JustARandomBoredGuy/Res-Novae/Media/nozzle and closure irl 1.jpg

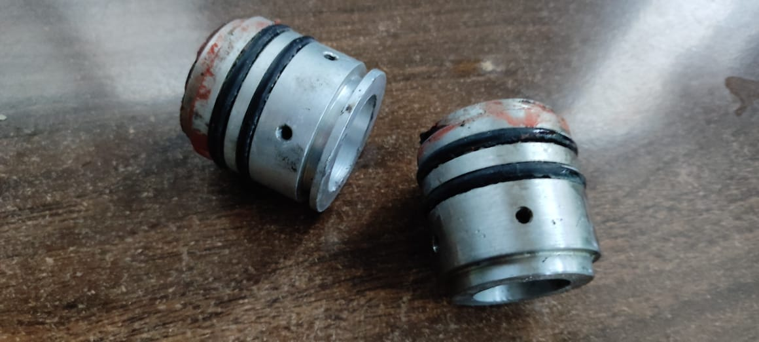
Media/nozzle and closure irl 1.jpg
