JustARandomBoredGuy/Res-Novae/Media/green thingy 50x.jpg

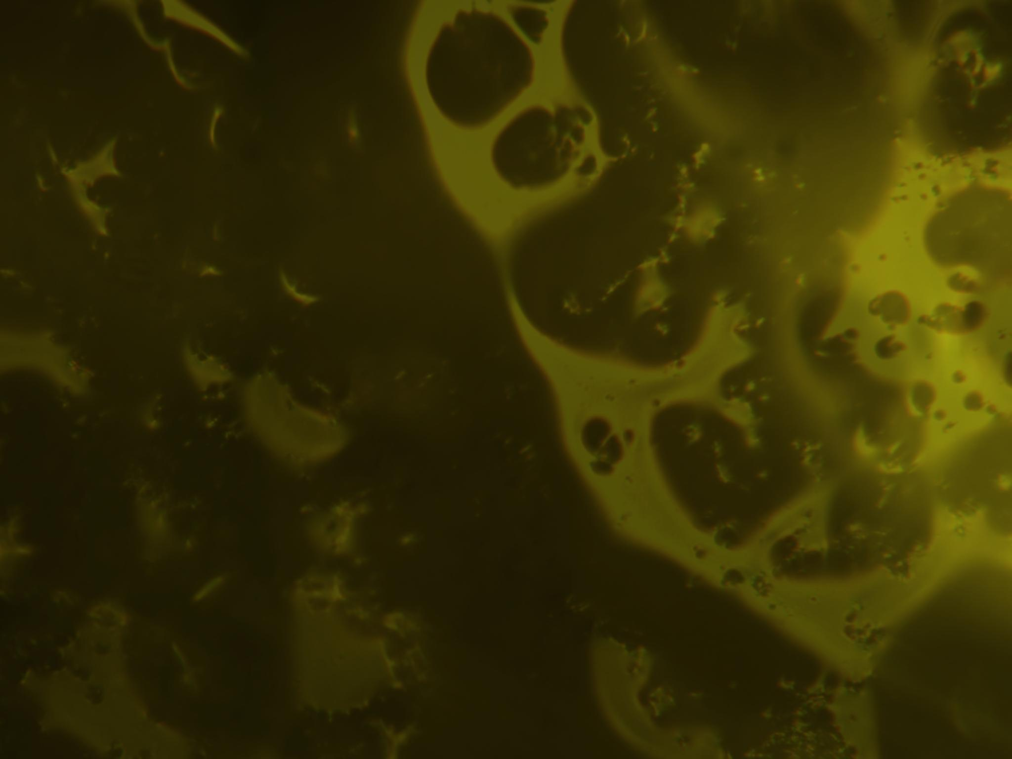
Media/green thingy 50x.jpg
