JustARandomBoredGuy/Res-Novae/README.md

# Res-Novae: Solid Propellant Telemetry System
Field Analysis to obtain thrust curves and impulse of varying propellant Compositions

## Tech Stack & Tools
Arduino IDE for embedded programming

LittleFS for storing web content on flash memory

AsyncWebServer for hosting a live dashboard

HTML + CSS + JavaScript for the front-end telemetry UI

## Visuals
Load Cell Setup:



NodeMCU and Dashboard:
