JustARandomBoredGuy/Res-Novae/Media/Aluminium 1.jpg

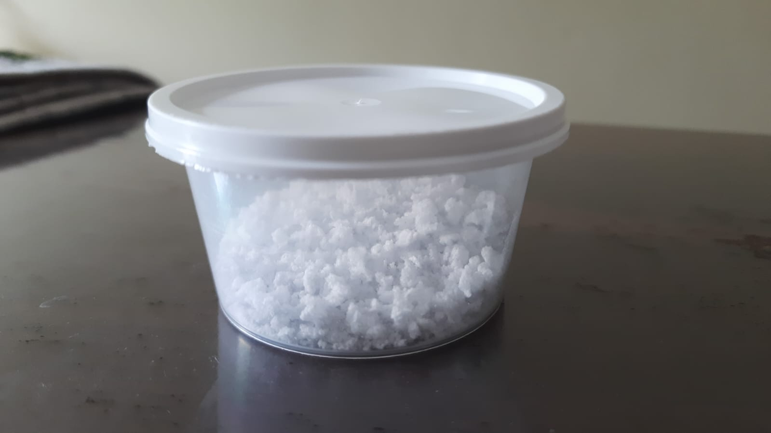
Media/Aluminium 1.jpg
