JustARandomBoredGuy/Res-Novae/Media/Caramalised KNDX 1.jpg

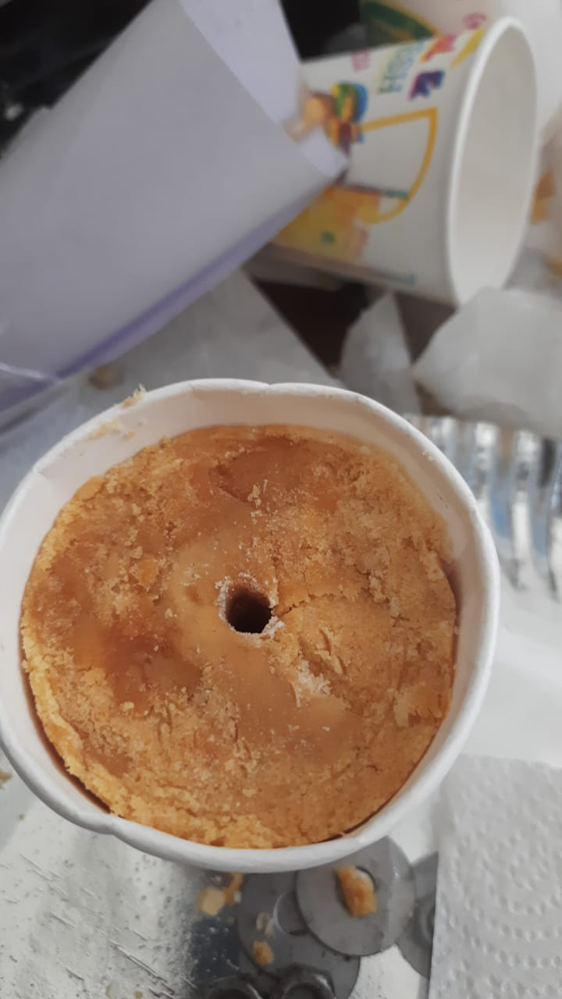
Media/Caramalised KNDX 1.jpg
