JustARandomBoredGuy/Res-Novae/Media/casing irl 1.jpg

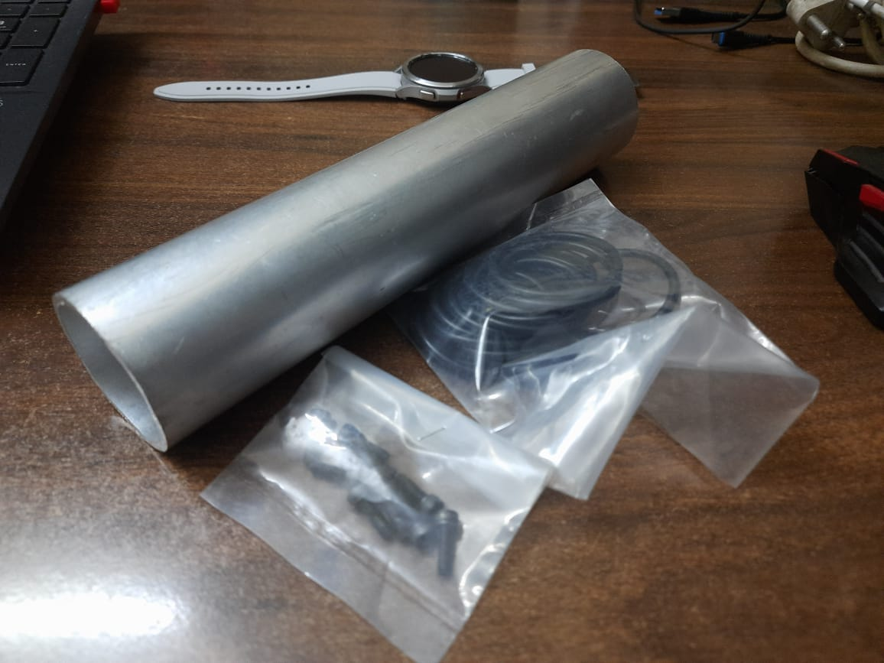
Media/casing irl 1.jpg
