JustARandomBoredGuy/Res-Novae/Media/casing irl 2.jpg

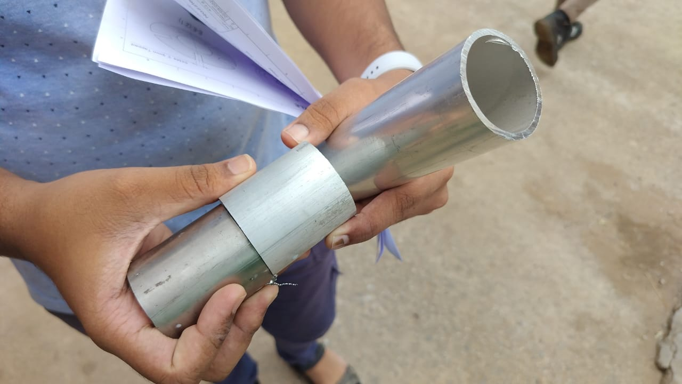
Media/casing irl 2.jpg
