JustARandomBoredGuy/Res-Novae/Media/FUEL.jpg

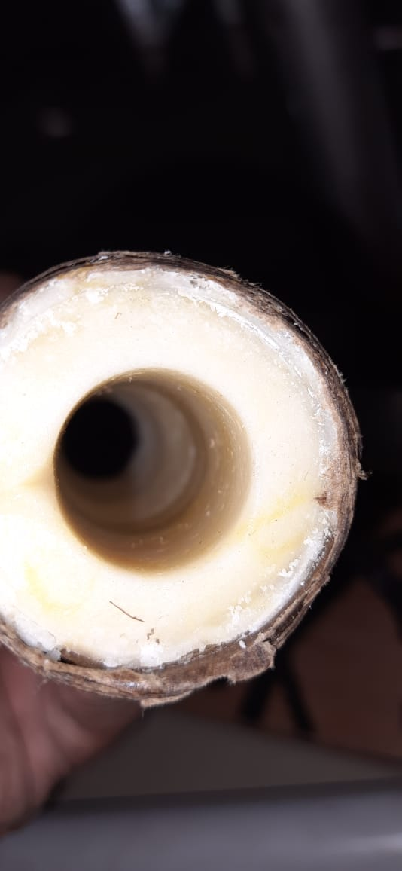
Media/FUEL.jpg
