JustARandomBoredGuy/Res-Novae/Media/green thingy 1.jpg

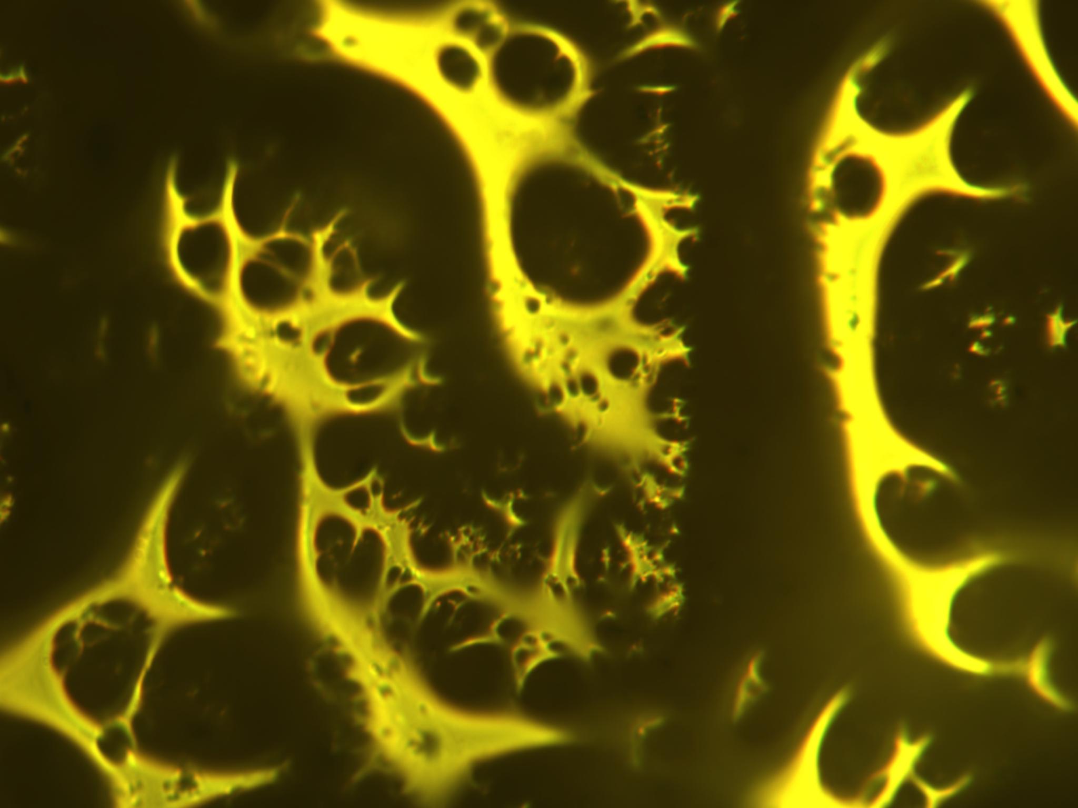
Media/green thingy 1.jpg
