JustARandomBoredGuy/Res-Novae/Media/liner 1.jpg

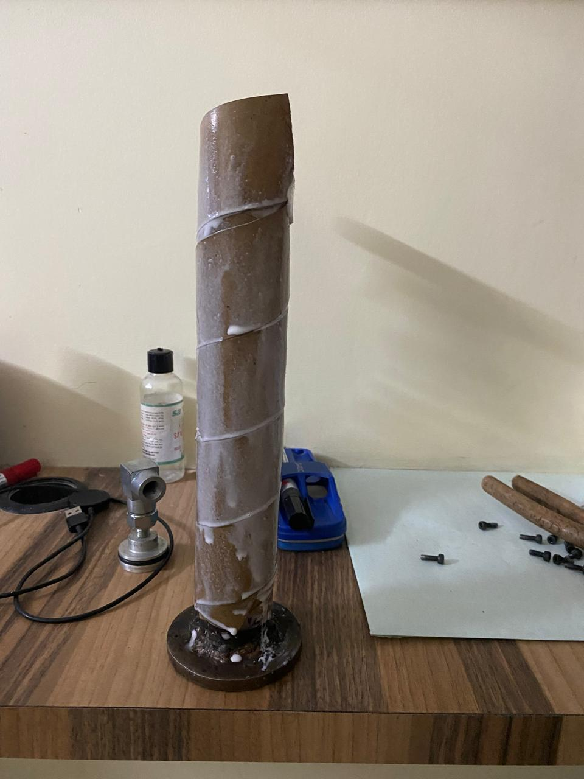
Media/liner 1.jpg
