JustARandomBoredGuy/Res-Novae/Media/liner 2.jpg

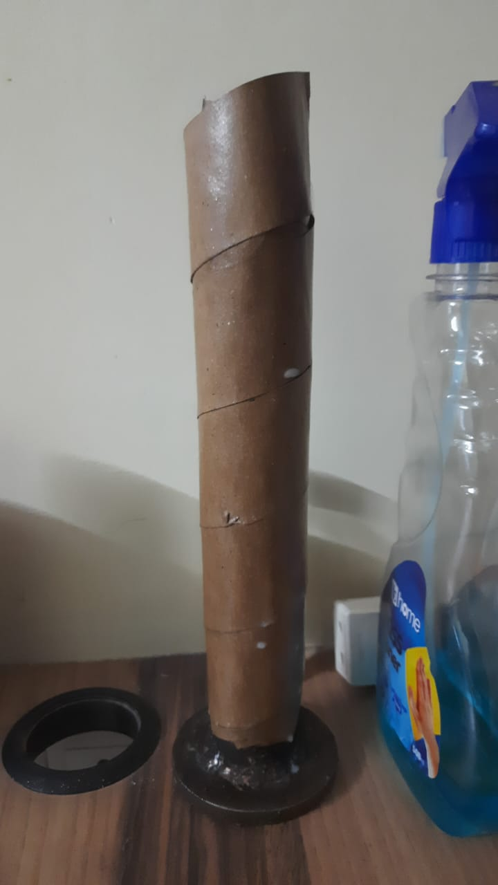
Media/liner 2.jpg
