JustARandomBoredGuy/Res-Novae/Media/model irl 1.jpg

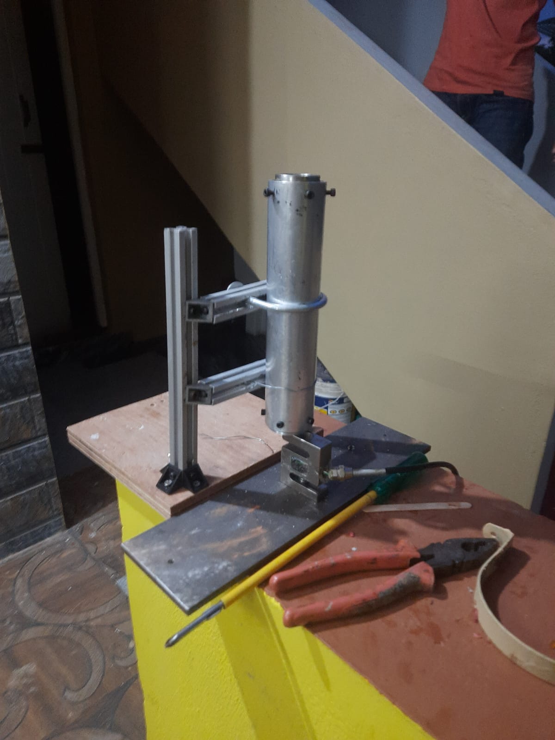
Media/model irl 1.jpg
