JustARandomBoredGuy/Res-Novae/Media/orange thingy 20x.jpg

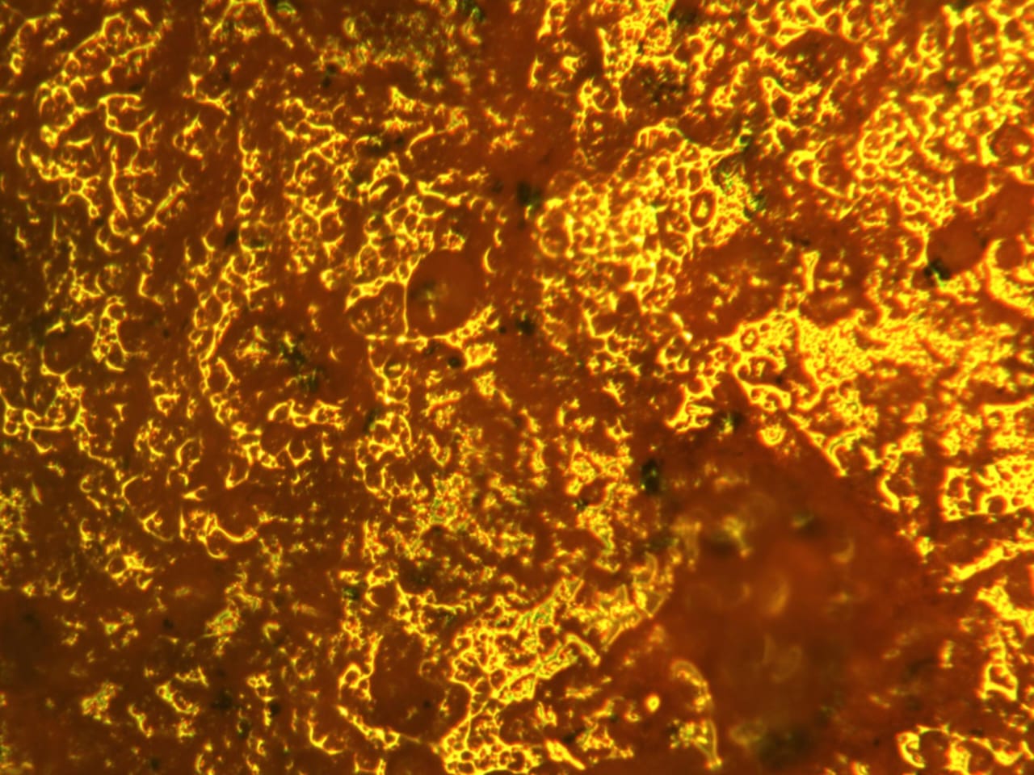
Media/orange thingy 20x.jpg
