JustARandomBoredGuy/Res-Novae/Media/orange thingy 50x.jpg

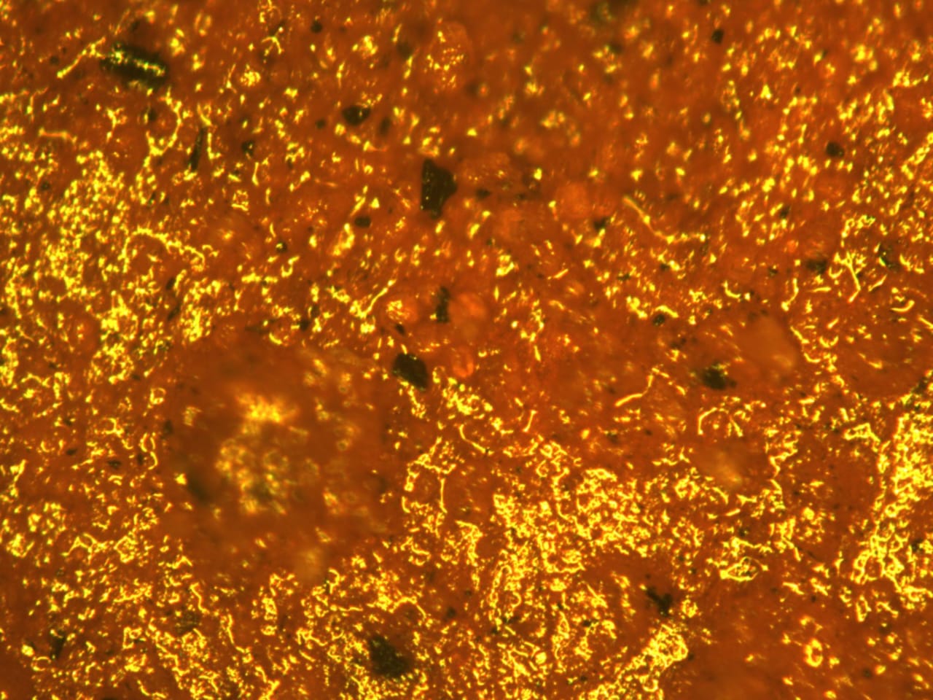
Media/orange thingy 50x.jpg
