JustARandomBoredGuy/Res-Novae/Media/pressure contour 1.jpg

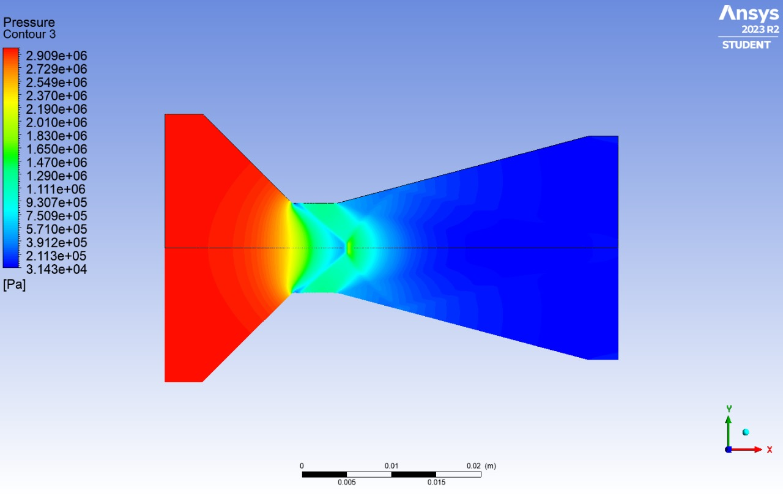
Media/pressure contour 1.jpg
