JustARandomBoredGuy/Res-Novae/Media/velocity contour 1.jpg

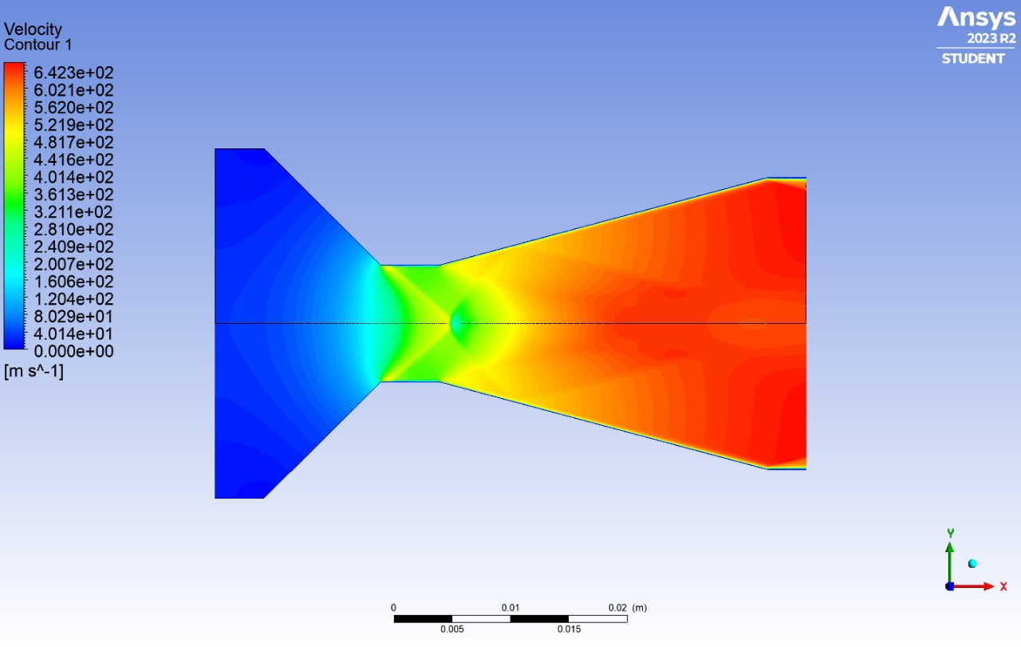
Media/velocity contour 1.jpg
