JustARandomBoredGuy/Res-Novae/Results/Thrust Curves.xlsx

Grams | Time (s) | Force (N) | Area | Ideal thrust
13.26 | 0.394 | 0.129948 | 0.08494395 | 0
13.41 | 1.044 | 0.131418 | 0.08710975 | 0
13.94 | 1.694 | 0.136612 | 0.0900081 | 0 | Burntime | 2.881
14.32 | 2.344 | 0.140336 | 0.09169615 | 0
14.47 | 2.994 | 0.141806 | 0.09411675 | 0
15.08 | 3.644 | 0.147784 | 0.10641085 | 0
18.33 | 4.294 | 0.179634 | 0.03276189 | 0
52.05 | 4.389 | 0.51009 | 0.091944384 | 0
143.41 | 4.485 | 1.405418 | 0.198261105 | 0
282.5 | 4.58 | 2.7685 | 0.34217974 | 0
452.58 | 4.675 | 4.435284 | 0.51459163 | 0
652.88 | 4.77 | 6.398224 | 3.703589347 | 0
7139.228873 | 4.867 | 69.96444296 | 7.343201023 | 122.2456
8635.63906 | 4.962 | 84.62926279 | 8.702555327 | 132.22437
10059.43146 | 5.057 | 98.58242831 | 9.890041512 | 142.19267 |  | 95.82117251
11186.62979 | 5.152 | 109.6289719 | 10.86683946 | 155.46847
11914.64457 | 5.248 | 116.7635168 | 11.36520391 | 165.41455
12246.07803 | 5.344 | 120.0115647 | 11.42948682 | 175.35192
12307.06229 | 5.439 | 120.6092104 | 11.45787499 | 188.58892
12307.06229 | 5.534 | 120.6092104 | 11.41220026 | 198.50753
12208.94256 | 5.629 | 119.6476371 | 11.35624644 | 208.41869
11932.7378 | 5.725 | 116.9408304 | 11.02785816 | 221.62249
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
