JustARandomBoredGuy/Res-Novae/Presentation/Res Novae Poster.pdf

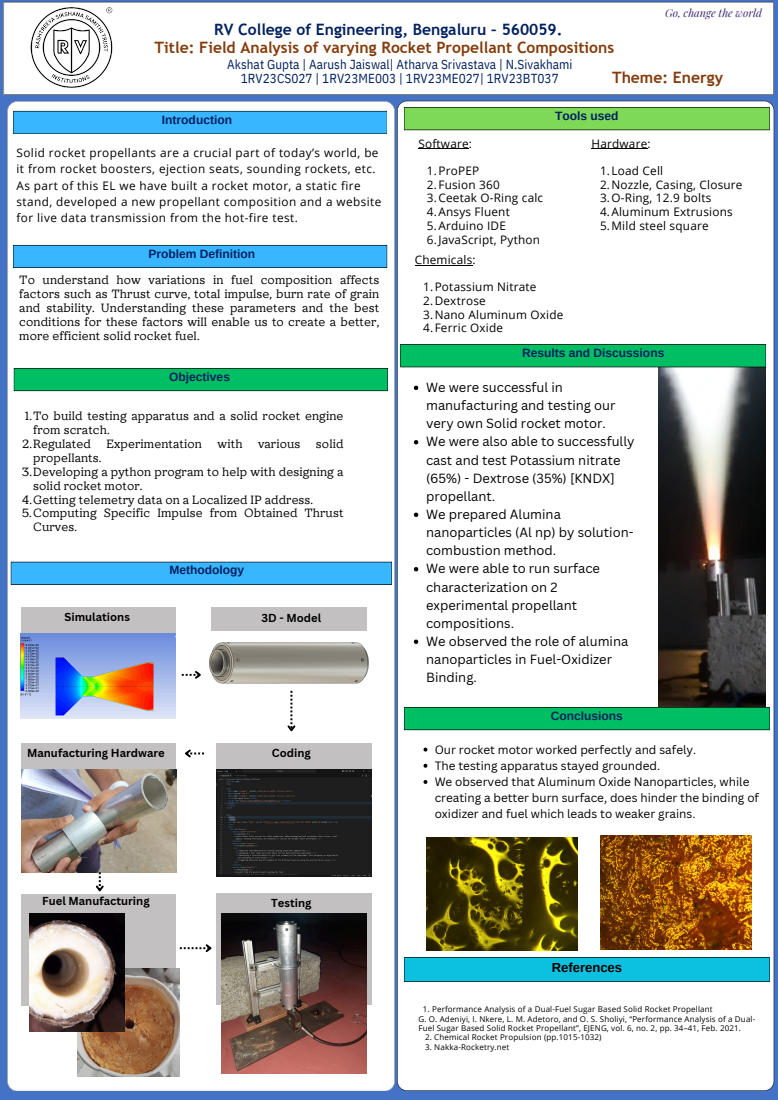
[picture p34: page 1]
Introduction; Methodology; References; Objectives; Problem Definition; Conclusions; Theme: Energy; Simulations; Manufacturing Hardware; Fuel Manufacturing; Testing; Coding; 3D - Model

Go, change the world

RV College of Engineering, Bengaluru – 560059.

Title: Field Analysis of varying Rocket Propellant Compositions

Akshat Gupta | Aarush Jaiswal| Atharva Srivastava | N.Sivakhami

Tools used
Hardware:
1.Load Cell
2.Nozzle, Casing, Closure
3.O-Ring, 12.9 bolts
4.Aluminum Extrusions
5.Mild steel square

Software:
1.ProPEP
2.Fusion 360
3.Ceetak O-Ring calc
4.Ansys Fluent
5.Arduino IDE
6.JavaScript, Python
Chemicals:
1.Potassium Nitrate
2.Dextrose
3.Nano Aluminum Oxide
4.Ferric Oxide

Solid rocket propellants are a crucial part of today’s world, be
it from rocket boosters, ejection seats, sounding rockets, etc.
As part of this EL we have built a rocket motor, a static fire
stand, developed a new propellant composition and a website
for live data transmission from the hot-fire test.

To understand how variations in fuel composition affects
factors such as Thrust curve, total impulse, burn rate of grain
and stability. Understanding these parameters and the best
conditions for these factors will enable us to create a better,
more efficient solid rocket fuel.

Results and Discussions

We were successful in
manufacturing and testing our
very own Solid rocket motor.
We were also able to successfully
cast and test Potassium nitrate
(65%) - Dextrose (35%) [KNDX]
propellant.
We prepared Alumina
nanoparticles (Al np) by solution-
combustion method.
We were able to run surface
characterization on 2
experimental propellant
compositions.
We observed the role of alumina
nanoparticles in Fuel-Oxidizer
Binding.

To build testing apparatus and a solid rocket engine
from scratch.
Regulated Experimentation with various solid
propellants.
Developing a python program to help with designing a
solid rocket motor.
4.Getting telemetry data on a Localized IP address.
Computing Specific Impulse from Obtained Thrust
Curves.

Our rocket motor worked perfectly and safely.
The testing apparatus stayed grounded.
We observed that Aluminum Oxide Nanoparticles, while
creating a better burn surface, does hinder the binding of
oxidizer and fuel which leads to weaker grains.

1. Performance Analysis of a Dual-Fuel Sugar Based Solid Rocket Propellant
G. O. Adeniyi, I. Nkere, L. M. Adetoro, and O. S. Sholiyi, “Performance Analysis of a Dual-
Fuel Sugar Based Solid Rocket Propellant”, EJENG, vol. 6, no. 2, pp. 34–41, Feb. 2021.
2. Chemical Rocket Propulsion (pp.1015-1032)
3. Nakka-Rocketry.net
