JustARandomBoredGuy/Res-Novae/CAD/H CLASS FINAL Drawing.pdf

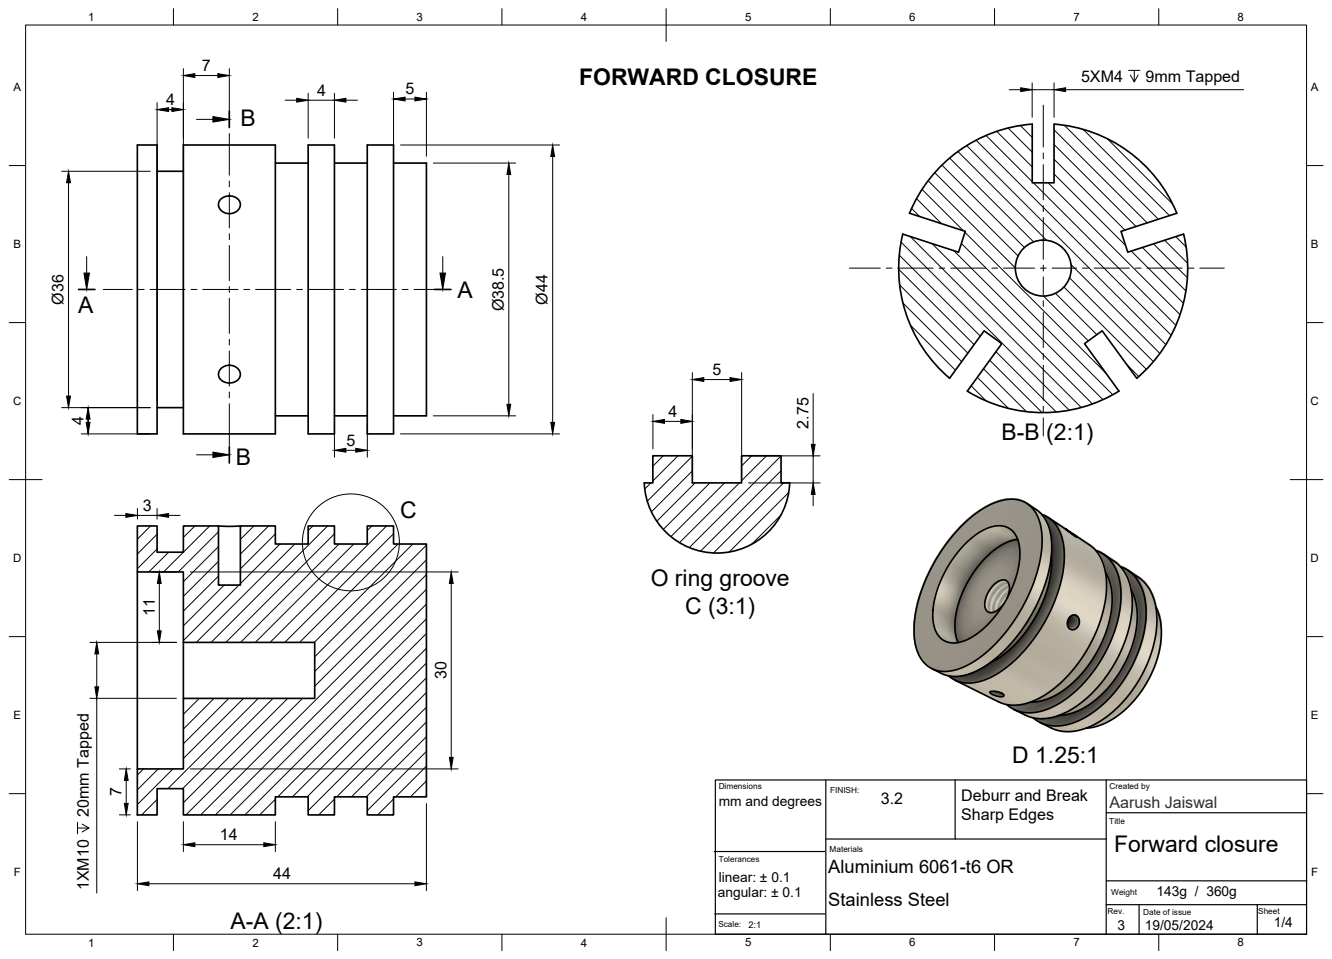
[picture p35: page 1]
Dimensions; FINISH:; Created by; Rev.; Date of issue; Sheet; Aluminium 6061-t6 OR; Forward closure; mm and degrees; Aarush Jaiswal; linear: ± 0.1; Stainless Steel; FORWARD CLOSURE; 9mm Tapped Ø38.5; 7 1XM10 20mm Tapped; angular: ± 0.1; O ring groove C (3:1)

Deburr and Break
Sharp Edges

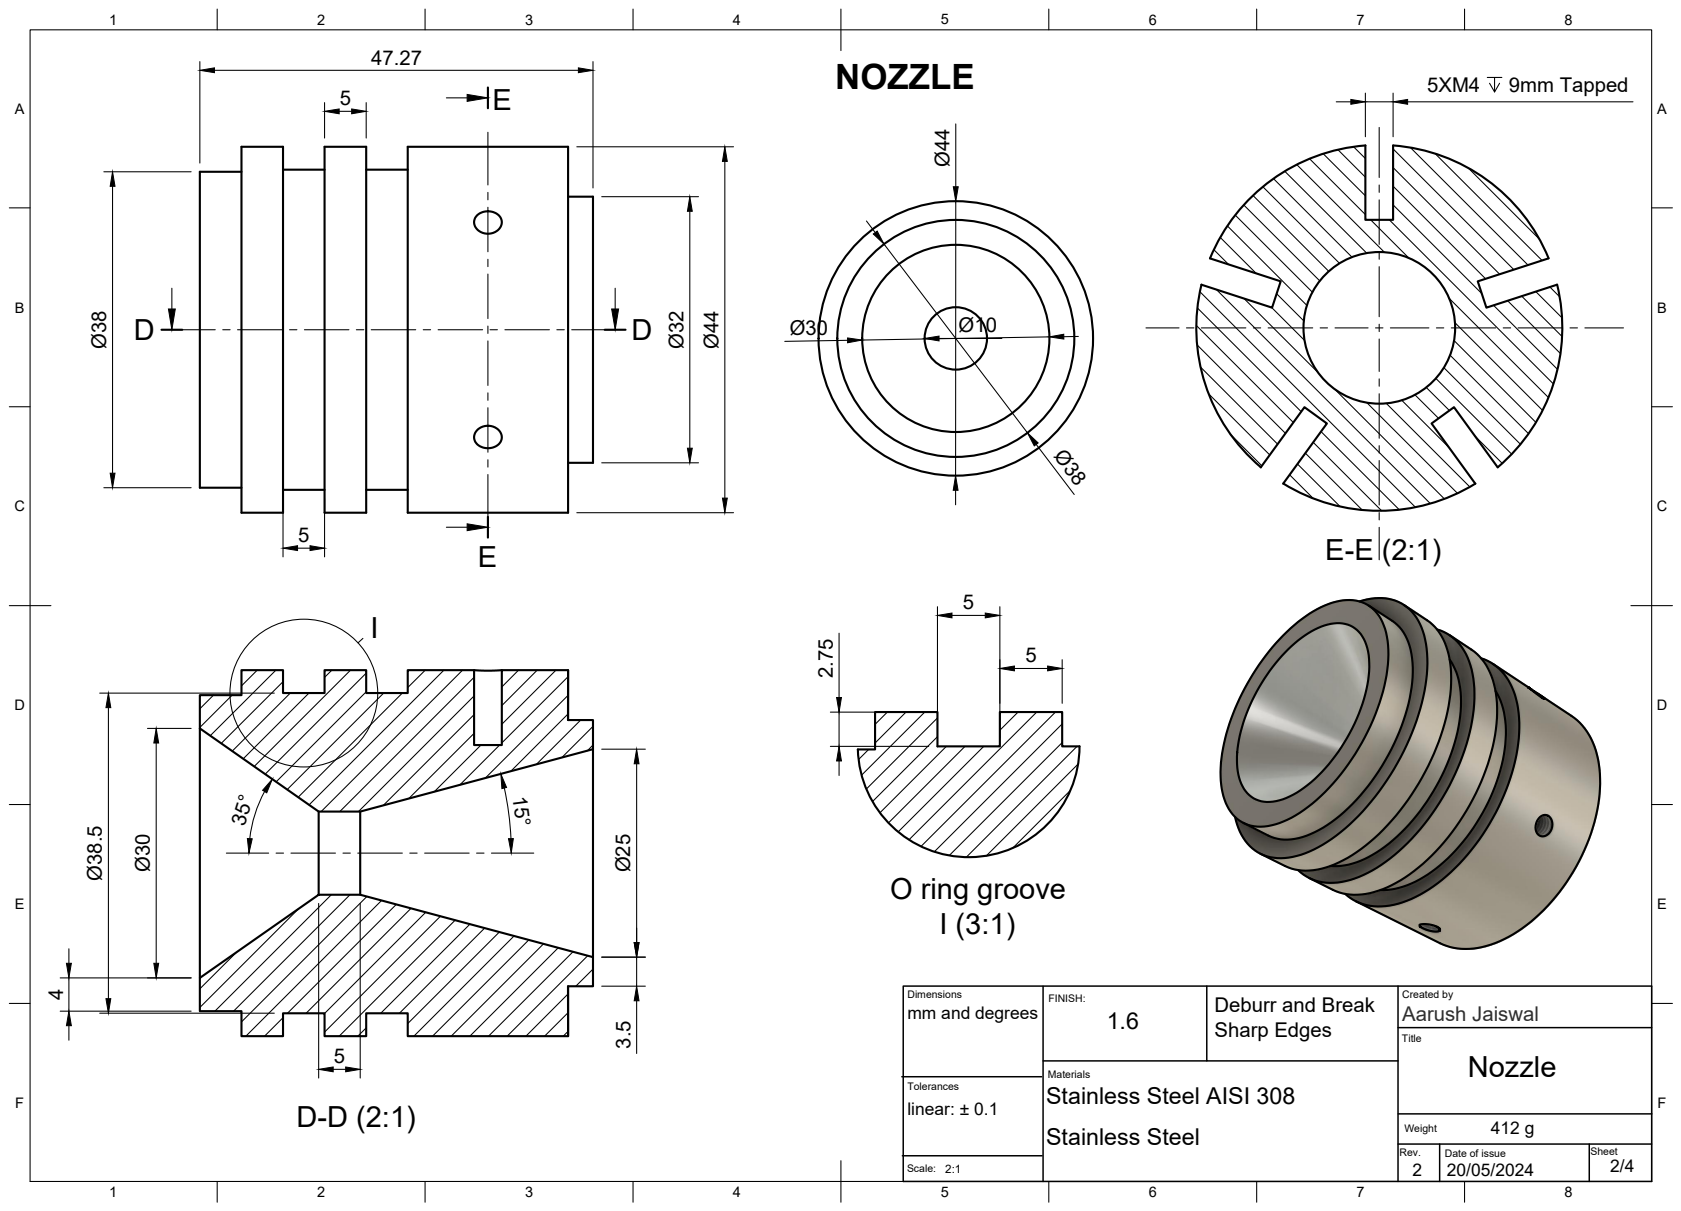
[picture p36: page 2]
Dimensions; FINISH:; Created by; mm and degrees; Aarush Jaiswal; linear: ± 0.1; NOZZLE Ø32; 9mm Tapped; O ring groove I (3:1)

Deburr and Break
Sharp Edges

Materials
Stainless Steel AISI 308
Stainless Steel

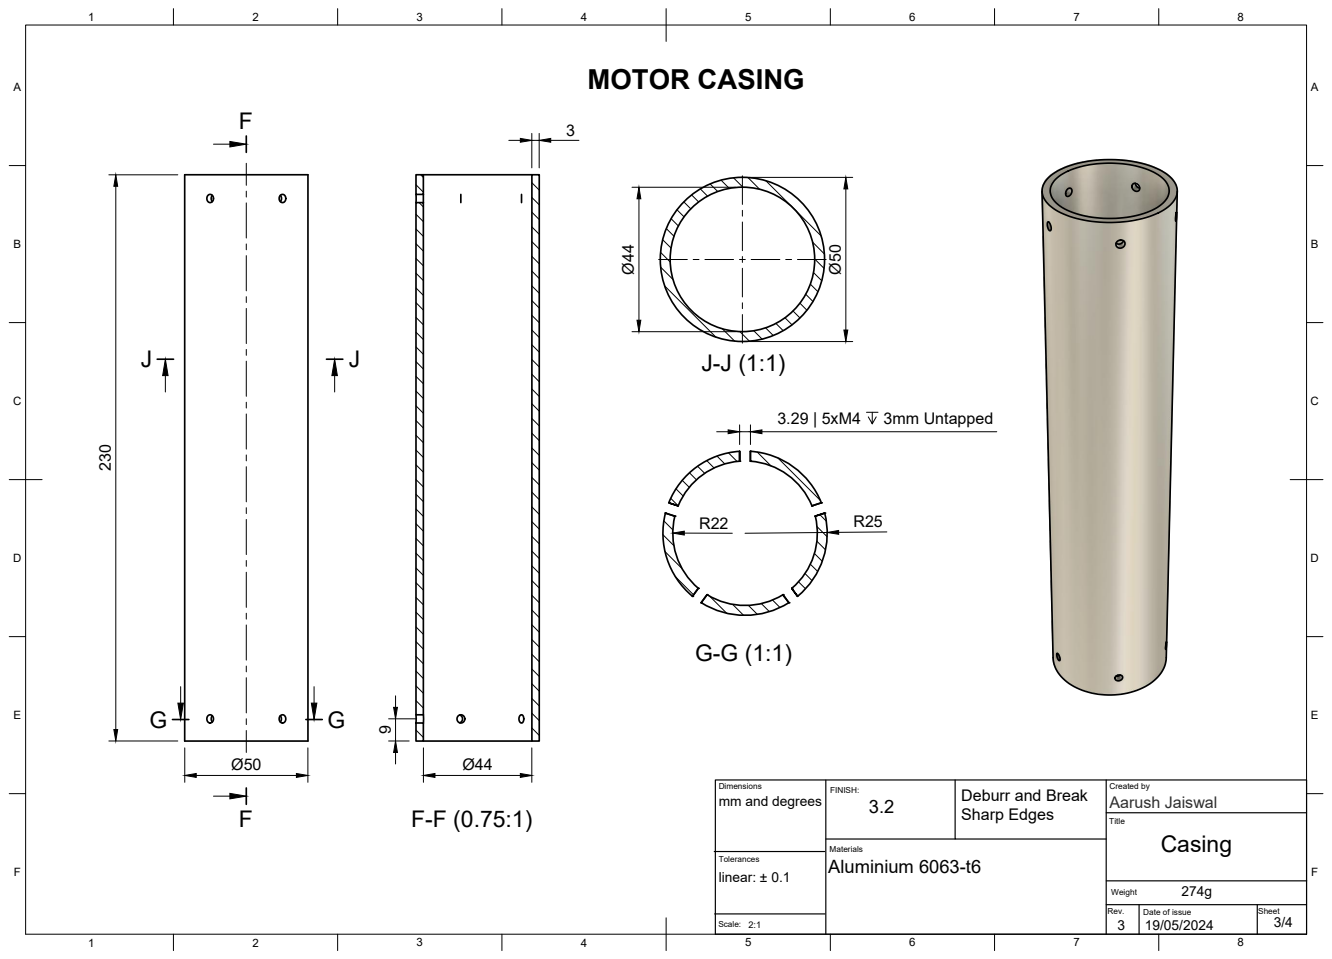
[picture p37: page 3]
Dimensions; FINISH:; Created by; Aluminium 6063-t6; mm and degrees; Aarush Jaiswal; linear: ± 0.1; MOTOR CASING 230; 3mm Untapped

Deburr and Break
Sharp Edges

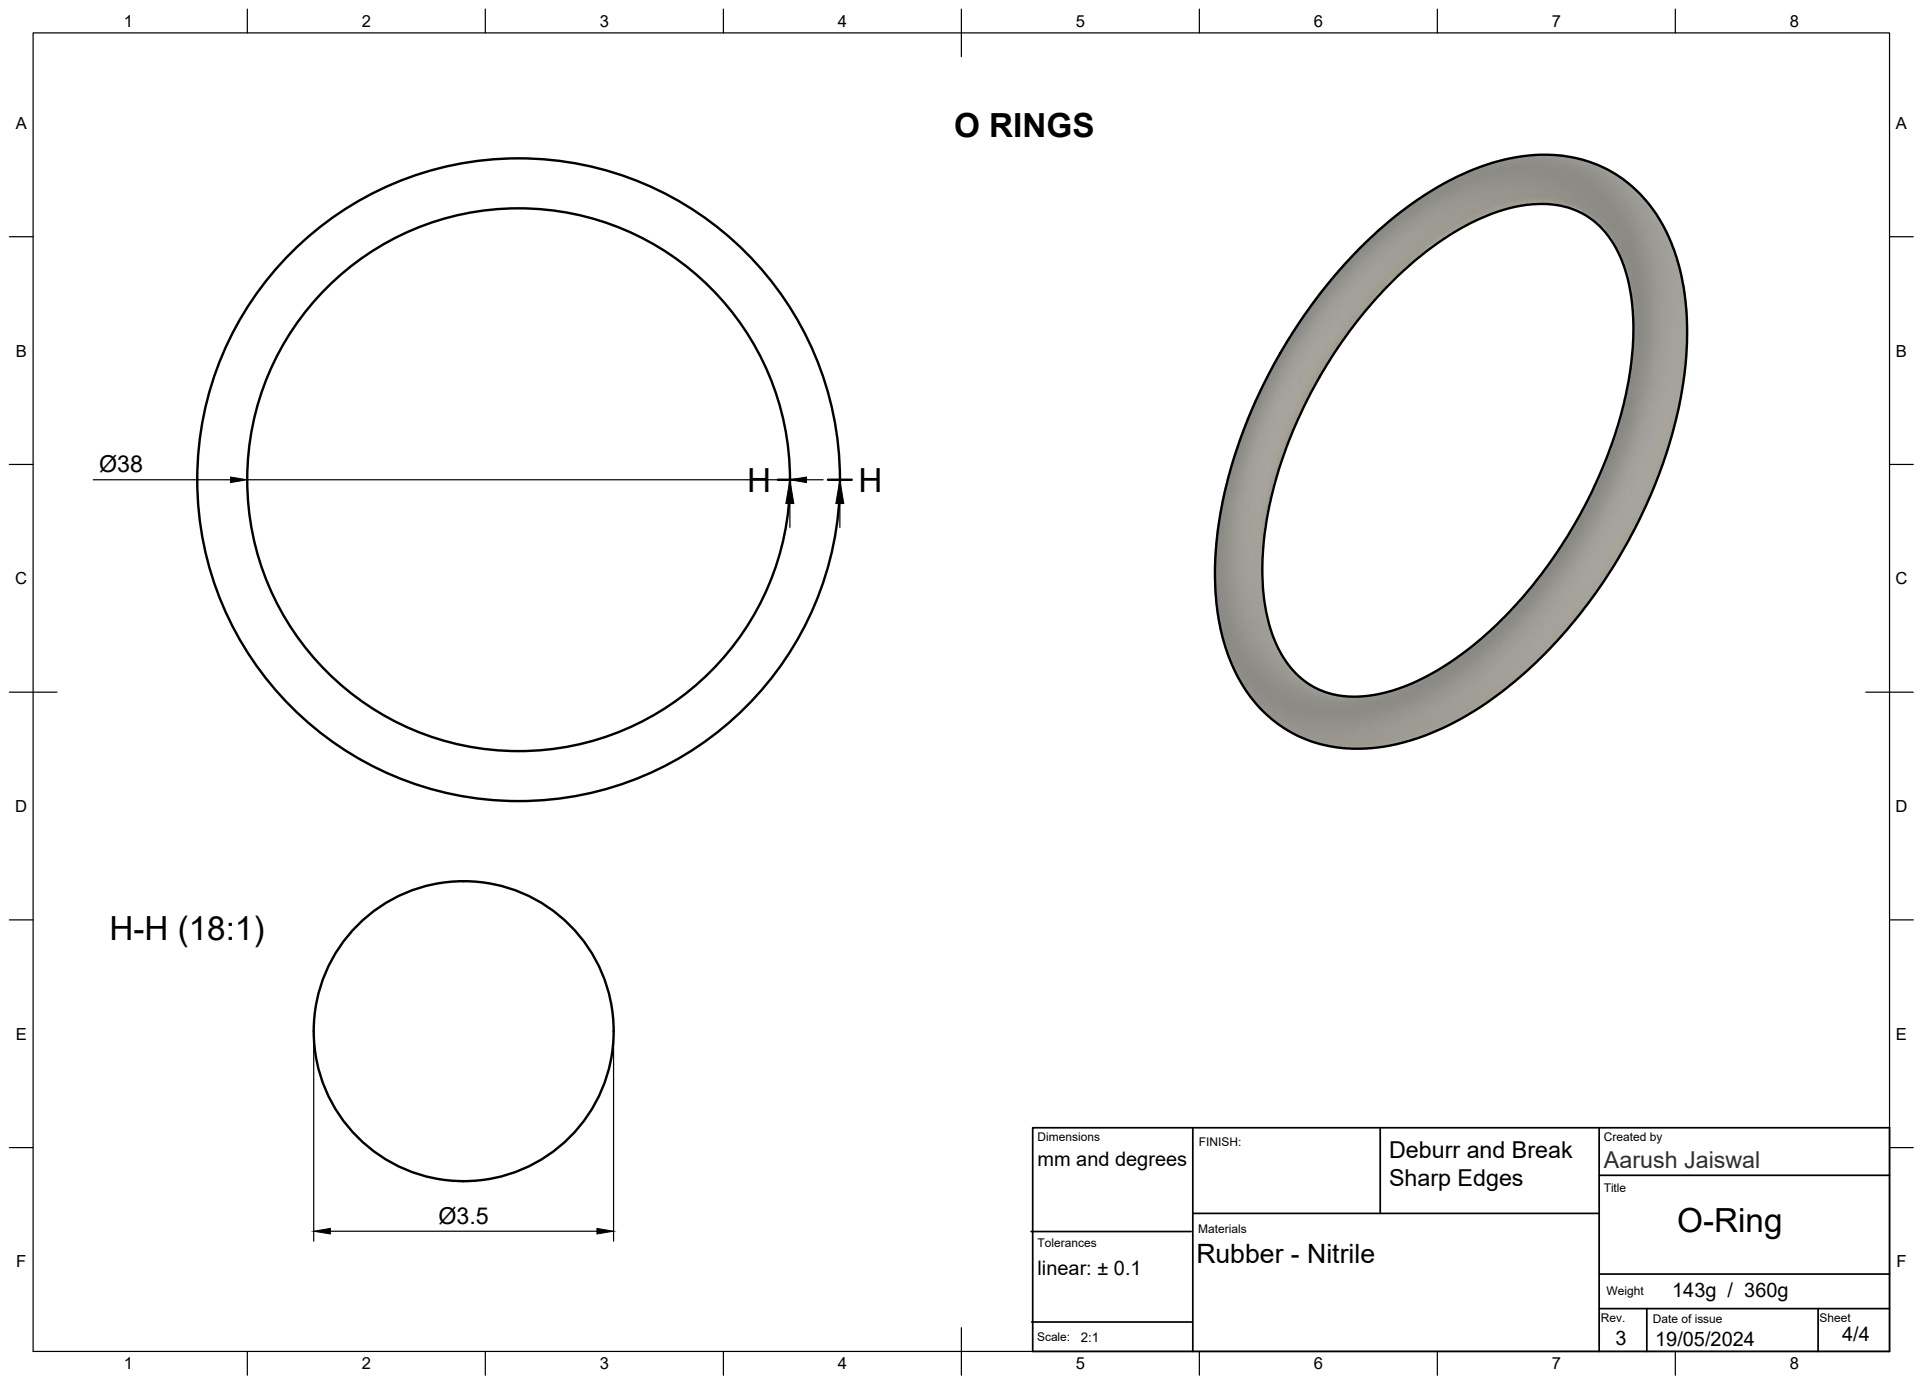
[picture p38: page 4]
Dimensions; FINISH:; Created by; Rubber - Nitrile; mm and degrees; Aarush Jaiswal; linear: ± 0.1; O RINGS

Deburr and Break
Sharp Edges
