JustARandomBoredGuy/Res-Novae/(commit log)

2025-06-17 Added CAD Drawings
2025-06-17 Added Results
    [Thrust Curves.xlsx, Thrustcurves.csv]
